maxterjunior/paracaidas-dron/README.md

# Paracaídas de Emergencia para DJI Matrice 400

Sistema autónomo que detecta la caída libre del dron con una IMU y despliega un paracaídas mediante un tubo de muelle. Funciona **independiente del flight controller**: tiene su propia batería, su MCU y su sensor.

<p align="center">
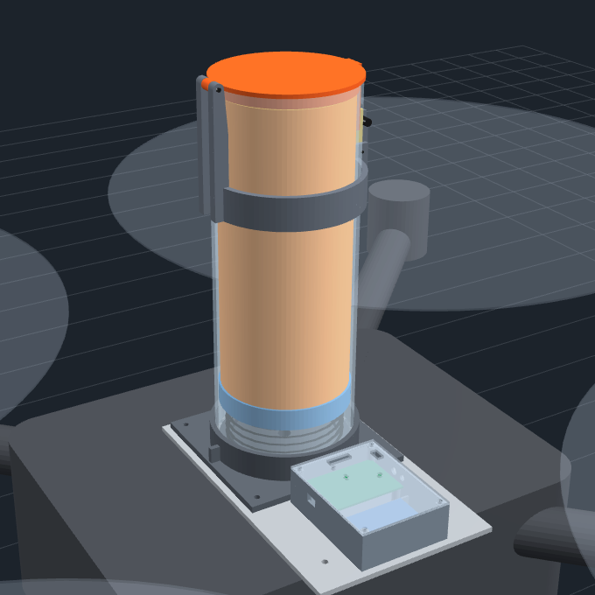
[picture p1: docs/img/mecanismo.png]
Mecanismo de tubo de muelle montado sobre el dron, con la caja de la electrónica al lado
  
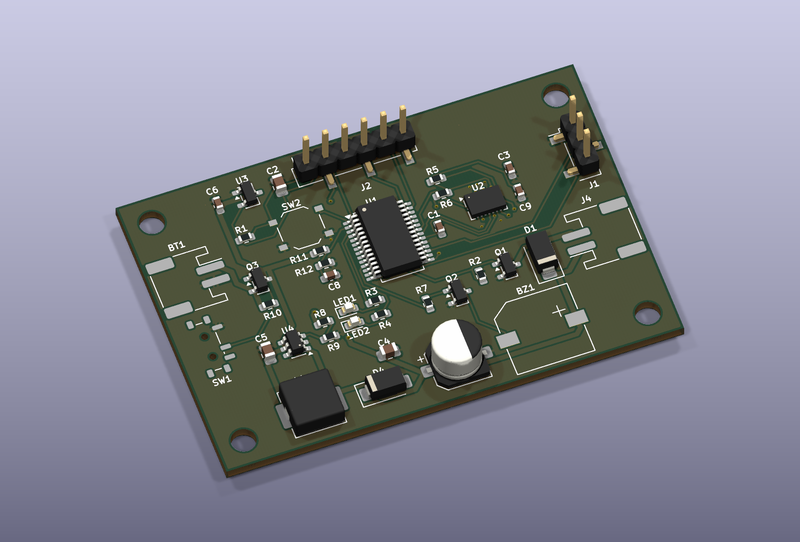
[picture p2: docs/img/pcb.png]
Render 3D de la placa de control de 60 × 40 mm
  
</p>
<p align="center"><sub>Izquierda: mecanismo en el <a href="https://claude.ai/artifact/HH7TuvKMzHhvBDsvPzRwz9">visor 3D</a>. Derecha: placa de control (render de KiCad).</sub></p>

| | |
|---|---|
| **Dron objetivo** | DJI Matrice 400: 9.74 kg con baterías, MTOW 15.8 kg |
| **MCU** | PIC18F25K22 (SSOP-28) con oscilador interno de 16 MHz sin PLL, 3.3 V |
| **IMU** | BMI088 (acelerómetro ±12 g + giróscopo ±1000 °/s) soldado en la placa, I²C: acel. 0x18 / giro 0x68 |
| **Actuador** | Solenoide 5 V que libera el pestillo de un tubo de muelle |
| **Mecanismo** | Tubo Ø100 × 280 mm con tapa articulada, modelo paramétrico OpenSCAD y [visor 3D](https://claude.ai/artifact/HH7TuvKMzHhvBDsvPzRwz9) |
| **Paracaídas** | Circular, ripstop nylon 30D, **Ø3.5 m**, 12 gajos, descenso ≤ 6 m/s a 16 kg |
| **Alimentación** | LiPo 1S 1000 mAh → interruptor MOSFET → LDO 3.3 V (XC6206) + boost 5.1 V (MT3608) |

## Estado

| Área | Estado |
|---|---|
| Investigación de módulos y paracaídas | ✅ Completa |
| Esquemático (KiCad 10, rev. v4, todo SMD) | ✅ Cableado, ERC limpio, campo LCSC en cada componente |
| PCB 2 capas 60 × 40 mm | ✅ Ruteado, planos de GND, DRC limpio, archivos JLCPCB listos |
| Firmware (MPLAB XC8) | 🚧 v0.1.0 escrita, sin compilar ni probar en hardware |
| Mecanismo (tubo de muelle) | 🚧 Modelo 3D y STL listos, sin interferencias; faltan medidas reales del solenoide y del montaje en el M400 |
| Canopia | ⏳ Pendiente (comprar o coser, ver `modulos.md`) |

## Cómo funciona

```
LiPo 1S ─Q3/SW1─┬─► XC6206 3.3V ─► PIC18F25K22 ◄─I²C─► BMI088
                │                       │
                └─► MT3608 5.1V ────────┼─► AO3400A ─► Solenoide ─► pestillo ─► muelle ─► paracaídas
                                        └─► LEDs / buzzer
```

1. El PIC lee el BMI088 a 500 Hz y filtra las señales con IIR de primer orden (solo aritmética entera, el PIC18 no tiene FPU).
2. Se **arma** solo en vuelo: cuando detecta la vibración de los motores durante 5 s. En tierra no dispara.
3. Armado, despliega si se cumple cualquiera de estos criterios: **caída libre** (|a| < 0.3 g durante 100 ms), **giro descontrolado** (|ω| > 250 °/s durante 300 ms) o **inclinación** (> 70° durante 500 ms).
4. Da dos pulsos de 300 ms al solenoide, que retrae el émbolo que bloquea la palanca del pestillo. La tapa se abre y el muelle expulsa el paracaídas en ~50–100 ms (ver [Mecanismo](#mecanismo)).
5. El pestillo retiene **sin energía**. Un reset nunca despliega por sí solo (R2 mantiene Q1 apagado), pero si el PIC se reinicia *durante* un despliegue, lo repite al arrancar.

Detalles en [`firmware/README.md`](firmware/README.md).

### Limitaciones conocidas

- **Altura mínima de despliegue: ~20–40 m.** Entre detección, expulsión e inflado se pierden 1.5–2.5 s.
- **La caída libre sola no basta.** Si falla un motor, el dron gira con los demás empujando y el acelerómetro no ve 0 g. Por eso el firmware también dispara por giro e inclinación. Falta un disparo manual por radio (RB2 libre) y calibrar los umbrales con vuelos reales.
- **No corta los motores.** El tubo debe expulsar hacia arriba, fuera del plano de las hélices.

## Estructura del repositorio

```
paracaidas-dron/
├── docs/
│   ├── esquematicos/esquematico.md   # Fuente de verdad: componentes, netlist pin a pin, notas
│   └── investigacion/modulos.md      # Selección de módulos, cálculo y construcción del paracaídas
├── hardware/
│   ├── paracaidas-matrice400/        # Proyecto KiCad 10 (.kicad_pro / .kicad_sch / .kicad_pcb)
│   │   ├── paracaidas.kicad_sym      # Símbolo propio (BMI088 en modo I2C)
│   │   ├── paracaidas.pretty/        # Footprint propio (buzzer MLT-9650)
│   │   └── jlcpcb/                   # Gerbers, BOM y CPL para pedir la placa armada
│   └── mecanismo/
│       ├── mecanismo.scad            # Modelo paramétrico OpenSCAD (tubo, tapa, pestillo, caja, adaptador)
│       ├── stl/                      # Piezas imprimibles exportadas
│       └── visor/                    # Visor 3D (three.js) generado desde los STL
├── firmware/                         # PIC18F25K22, MPLAB XC8 (ver firmware/README.md)
│   ├── src/                          # main, detector, configuración, placa
│   ├── lib/                          # HAL (tick, I2C, UART, ADC) y driver BMI088
│   └── test/                         # pruebas de la lógica de detección en la PC
├── CLAUDE.md                         # Guía para Claude Code
└── README.md
```

## Primeros pasos

### Abrir el hardware

1. Instala [KiCad 10](https://www.kicad.org/download/).
2. Abre `hardware/paracaidas-matrice400/paracaidas-matrice400.kicad_pro`.

Para verificar el diseño desde la línea de comandos:

```sh
KICAD="C:/Program Files/KiCad/10.0/bin/kicad-cli.exe"
cd hardware/paracaidas-matrice400

"$KICAD" sch erc paracaidas-matrice400.kicad_sch
"$KICAD" pcb drc --schematic-parity paracaidas-matrice400.kicad_pcb
```

### Firmware

```sh
cd firmware
make          # build/paracaidas.hex (MPLAB XC8)
make test     # lógica de detección en la PC (gcc)
```

- Programado con PICkit por el header ICSP **J2** (RB6/RB7).
- Log de estado por el header UART **J1** (RC6 TX / RC7 RX), 115200 8N1.
- Instrucciones, estados, LEDs y calibración en [`firmware/README.md`](firmware/README.md).

## Cambiar el diseño

[`docs/esquematicos/esquematico.md`](docs/esquematicos/esquematico.md) es la **fuente de verdad** de la conectividad. Las referencias coinciden 1:1 con el `.kicad_sch` y el `.kicad_pcb`.

Para cualquier cambio de conexiones:

1. Actualiza el documento **y** el esquemático, y corre el ERC.
2. Actualiza el PCB desde el esquemático (F8) y vuelve a rutear las redes afectadas.
3. Rellena las zonas (B) y corre el DRC con `--schematic-parity`.

Netclasses del PCB: `Default` 0.2 mm con 0.15 mm de separación (paso fino del SSOP-28 y del LGA-16) y `Power` 0.6 mm (+5V, VBAT, SW_NODE, SOL_DRV, BAT+). GND va por plano de cobre en ambas caras.

### Pedir la placa a JLCPCB

1. Sube `hardware/paracaidas-matrice400/jlcpcb/paracaidas-matrice400-gerbers.zip` (se genera junto con los gerbers y no se versiona; si no está, comprime la carpeta `gerbers/`).
2. En PCB Assembly sube `bom_jlcpcb.csv` y `cpl_jlcpcb.csv` (cara superior).
3. Revisa la rotación de los componentes en el visor antes de confirmar. Todos los componentes, incluidos los conectores, los monta JLCPCB.

Si cambias el PCB, vuelve a exportar gerbers, taladros y posiciones con `kicad-cli pcb export gerbers|drill|pos`.

## Mecanismo

Tubo de muelle montado sobre el dron con una placa adaptadora. **[Ver el modelo en 3D](https://claude.ai/artifact/HH7TuvKMzHhvBDsvPzRwz9)**: tiene animación del despliegue, vista en corte y el nombre de cada pieza al pasar el ratón.

| Pieza | Qué hace | Material |
|---|---|---|
| Tubo Ø105/Ø100 × 280 mm | Aloja ~1.6 L de paracaídas plegado | PETG impreso o tubo PVC 110 mm |
| Base | Encaje del tubo, asiento del resorte, paso central del cordón de anclaje | PETG |
| Pistón | Empuja el paracaídas | PETG |
| Resorte Ø90 mm | Comprimido a 45 mm en vuelo | Acero (comprado) |
| Tapa articulada | Se abre sobre su bisagra y queda unida al tubo; su pestaña tiene la ventana del pestillo | PETG |
| Collar | Bisagra, pivote de la palanca, guía del émbolo y repisa del solenoide | PETG |
| Palanca del pestillo | Su gancho entra en la ventana de la tapa | PETG o PA |
| Solenoide 5 V push-pull | El émbolo bloquea la palanca de costado | JF-0530B (comprado) |
| Caja electrónica | PCB 60 × 40 + LiPo 1S; tapa con agujeros sobre LEDs, buzzer, reset, J1 y J2 | PETG |
| Placa adaptadora | Une tubo y caja al dron | Aluminio 4 mm o PETG |

**Cómo traba:** la carga del resorte pasa a 2.7 mm del pivote de la palanca, así que el émbolo solo la bloquea de costado y le basta un solenoide pequeño. Sin energía, el muelle del solenoide deja el émbolo extendido y la tapa trabada. La boca del tubo queda ~273 mm por encima del plano de las hélices.

**Verificado con OpenSCAD:** ninguna pieza montada se cruza con otra. La tapa abre de 0° a 118° sin chocar, la palanca gira 22° libre con el émbolo retraído y queda bloqueada con el émbolo extendido.

**Antes de fabricar hay que medir:**

- El solenoide real (cuerpo, carrera, largo del émbolo): parámetros `sol_*`.
- El punto de montaje superior del M400: el patrón de tornillos de la placa (`montaje_*`) y la envolvente del dron son provisionales.
- La fuerza del resorte: debe sacar ~0.6 kg por encima de las hélices. Probar en banco.

> El cordón de anclaje se ata a la **estructura del dron**, no a piezas impresas: el choque de apertura con 16 kg es de cientos de newtons.

### Exportar las piezas

Instala [OpenSCAD](https://openscad.org/downloads.html) y exporta cada pieza:

```sh
cd hardware/mecanismo
openscad -D 'pieza="tapa"' -o stl/tapa.stl mecanismo.scad
```

Piezas imprimibles: `base`, `tubo`, `piston`, `tapa`, `collar`, `palanca`, `caja`, `tapa_caja`, `adaptador`. Las medidas están como parámetros al inicio del `.scad`. Los STL salen en posición de montaje, así que hay que orientarlos en el slicer. El tubo necesita ~290 mm de altura de impresión; si no alcanza, usa PVC.

### Visor 3D

`hardware/mecanismo/visor/index.html` se abre con doble clic, sin servidor. Carga las piezas de `piezas.js`, que contiene los STL de OpenSCAD en base64. Si cambias el `.scad`, regenera ese archivo:

```sh
python hardware/mecanismo/visor/empaquetar.py "C:/Program Files/OpenSCAD/openscad.com"
```

## Paracaídas

El dimensionamiento completo, el patrón de gajos, la costura y los proveedores (Fruity Chutes, Mars Parachutes, modelos para 15–16 kg) están en [`docs/investigacion/modulos.md`](docs/investigacion/modulos.md#paracaídas--canopia-y-mecanismo-de-despliegue).

```
Área = 2·m·g / (Cd·ρ·v²) = (2 × 16 × 9.81) / (0.75 × 1.225 × 6²) ≈ 9.5 m²  →  Ø3.5 m
```

> Los paracaídas de Ø1.2 m que venden en AliExpress son para drones de 2–4 kg. Con el M400 darían 14–17 m/s de descenso, el equivalente a soltarlo desde 10–15 m.

## Commits

Este repo usa [Conventional Commits](https://www.conventionalcommits.org/es/v1.0.0/) con emoji y la descripción en español:

```
feat(hardware): ✨ esquemático cableado sin r5/r6 y pcb ruteado con plano de gnd
```
