maxterjunior/paracaidas-dron/hardware/mecanismo/visor/index.html

Mecanismo Pestillo Dron Paracaídas

arrastrar: girar · rueda: zoom · clic derecho: desplazar
dron = envolvente aproximada

# Paracaídas M400 · Mecanismo

Tubo de muelle Ø100 × 280 mm con tapa articulada y pestillo por solenoide, montado sobre el dron.

## Despliegue

▶ Disparar

Dron Corte Plano de hélices

## Secuencia

1. En vuelo el solenoide está apagado: su muelle mantiene el émbolo extendido y bloquea la palanca.
2. El PIC detecta la falla y da un pulso de ~300 ms: el émbolo se retrae 10 mm.
3. La carga del resorte cae 2.7 mm por dentro del pivote, así que la palanca gira hacia afuera y suelta la pestaña.
4. La tapa abre sobre su bisagra (queda unida al tubo) y el pistón expulsa el paracaídas hacia arriba.
5. El cordón de anclaje pasa por el centro de la base y va a la estructura del dron.

## Piezas

## Cotas principales

Tubo (interior × largo) | Ø100 × 280 mm
Volumen útil para el paracaídas | ≈ 1.6 L
Boca del tubo sobre el plano de hélices | ≈ 273 mm
Resorte (ext. × comprimido) | Ø90 × 45 mm
Brazo de la carga respecto al pivote | 2.7 mm
Carrera del émbolo | 10 mm
Placa adaptadora | 140 × 232 × 4 mm
Caja electrónica (PCB 60×40 + LiPo) | 70 × 90 × 30 mm

## Por verificar

- Medidas del solenoide real (cuerpo, carrera, largo del émbolo). El modelo usa un JF-0530B de 5 V.
- Patrón de tornillos de la placa adaptadora: es provisional, hay que medir el punto de montaje superior del M400.
- El cordón de anclaje debe ir a la estructura del dron, no a piezas impresas: el choque de apertura con 16 kg es de cientos de newtons.
- Fuerza del resorte para sacar ~0.6 kg por encima de las hélices; probar en banco antes de volar.

## Fuente CAD

Todas las piezas del visor son los STL exportados de hardware/mecanismo/mecanismo.scad con OpenSCAD, los mismos de hardware/mecanismo/stl/, empaquetados en visor/piezas.js con visor/empaquetar.py. Sólo el PCB, la batería, los pasadores y la canopia inflada son esquemáticos. Para exportar una pieza: openscad -D 'pieza="tapa"' -o tapa.stl mecanismo.scad.
