maxterjunior/paracaidas-dron/hardware/paracaidas-matrice400/jlcpcb/bom_jlcpcb.csv

Comment | Designator | Footprint | LCSC Part #
LiPo 1S | BT1 | JST_PH_S2B-PH-SM4-TB_1x02-1MP_P2.00mm_Horizontal | C295747
MLT-9650 5V | BZ1 | Buzzer_MLT-9650 | C96127
100nF | C1,C3,C8,C9 | C_0603_1608Metric | C14663
10µF | C2 | C_0805_2012Metric | C15850
22µF | C4,C5 | C_0805_2012Metric | C45783
1µF | C6 | C_0603_1608Metric | C15849
220µF 10V | C7 | CP_Elec_6.3x5.4 | C72494
SS34 | D1,D4 | D_SMA | C8678
UART debug | J1 | PinHeader_1x03_P2.54mm_Vertical_SMD_Pin1Left | C41417360
ICSP PICkit | J2 | PinHeader_1x06_P2.54mm_Vertical_SMD_Pin1Right | C41417363
SOL1 Solenoide 5V | J4 | JST_PH_S2B-PH-SM4-TB_1x02-1MP_P2.00mm_Horizontal | C295747
22µH 3A | L1 | L_Changjiang_FXL0630 | C177244
Verde | LED1 | LED_0603_1608Metric | C12624
Rojo | LED2 | LED_0603_1608Metric | C2286
AO3400A | Q1 | SOT-23 | C20917
MMBT3904 | Q2 | SOT-23 | C20526
AO3401A | Q3 | SOT-23 | C15127
10k | R1,R2 | R_0603_1608Metric | C25804
100 | R3 | R_0603_1608Metric | C22775
330 | R4 | R_0603_1608Metric | C23138
4.7k | R5,R6 | R_0603_1608Metric | C23162
1k | R7 | R_0603_1608Metric | C21190
750k 1% | R8 | R_0603_1608Metric | C23240
100k 1% | R9 | R_0603_1608Metric | C25803
100k | R10,R11,R12 | R_0603_1608Metric | C25803
ON/OFF | SW1 | SW_SPDT_Shouhan_MSK12C02 | C431540
RESET | SW2 | SW_Push_1P1T_XKB_TS-1187A | C318884
PIC18F25K22-I/SS | U1 | SSOP-28_5.3x10.2mm_P0.65mm | C51680
BMI088 | U2 | Bosch_LGA-16_4.5x3mm_P0.5mm_LayoutBorder7x1y_ClockwisePinNumbering | C194919
XC6206P332MR | U3 | SOT-23-3 | C5446
MT3608 | U4 | SOT-23-6 | C84817
