maxterjunior/paracaidas-dron/hardware/mecanismo/stl/adaptador.stl

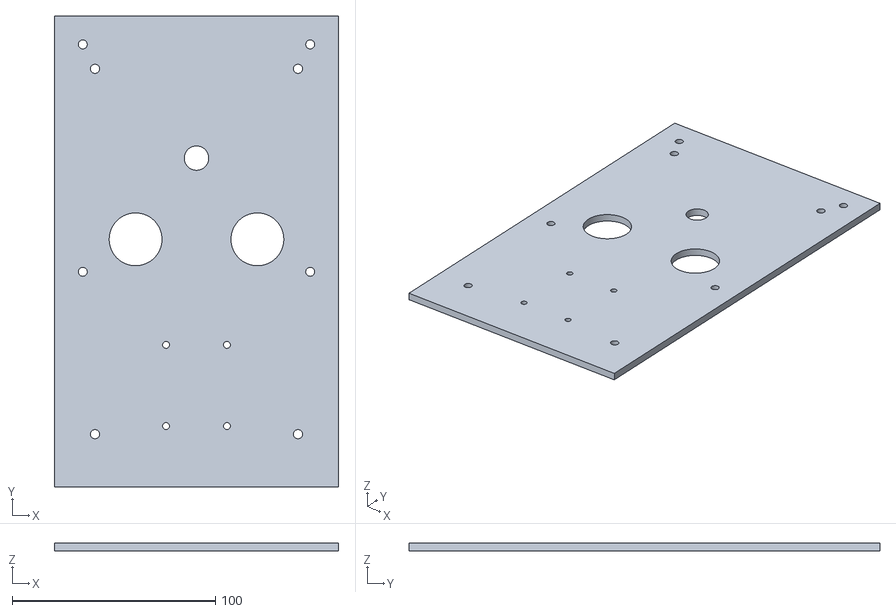
[picture p3: CAD file, 2026-11-09]
hardware/mecanismo/stl/adaptador.stl
140.0 x 232.0 x 4.00
