maxterjunior/paracaidas-dron/hardware/mecanismo/stl/tapa_caja.stl

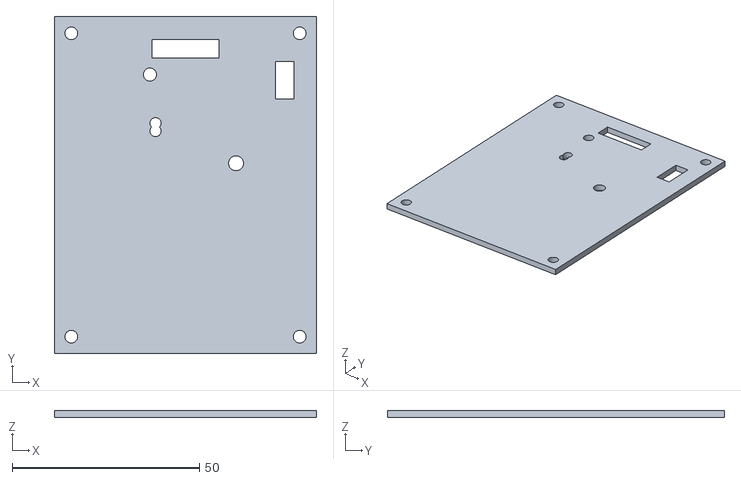
[picture p4: CAD file, 2026-11-09]
hardware/mecanismo/stl/tapa_caja.stl
70.0 x 90.0 x 2.00
