maxterjunior/paracaidas-dron/hardware/mecanismo/stl/collar.stl

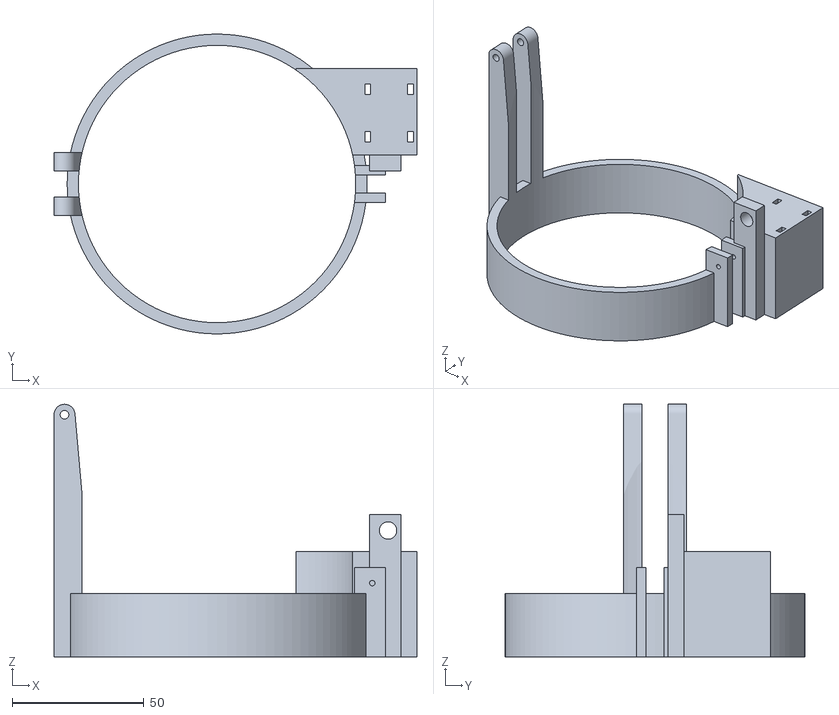
[picture p5: CAD file, 2026-11-09]
hardware/mecanismo/stl/collar.stl
138.0 x 114.0 x 96.0
