maxterjunior/paracaidas-dron/hardware/mecanismo/stl/palanca.stl

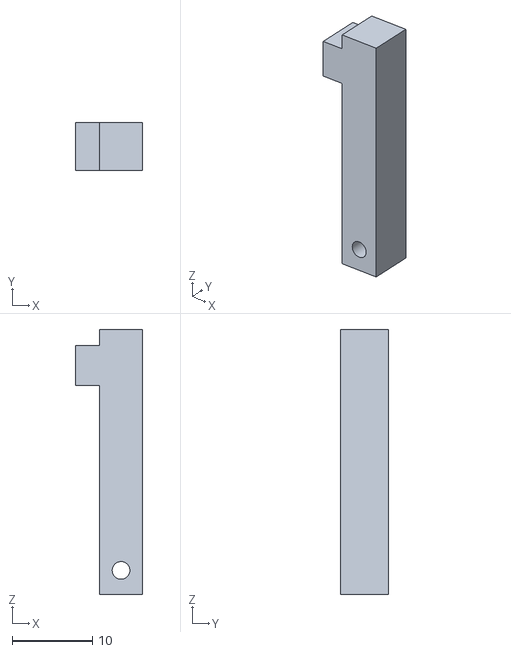
[picture p6: CAD file, 2026-11-09]
hardware/mecanismo/stl/palanca.stl
8.40 x 6.00 x 33.0
