maxterjunior/paracaidas-dron/hardware/mecanismo/stl/piston.stl

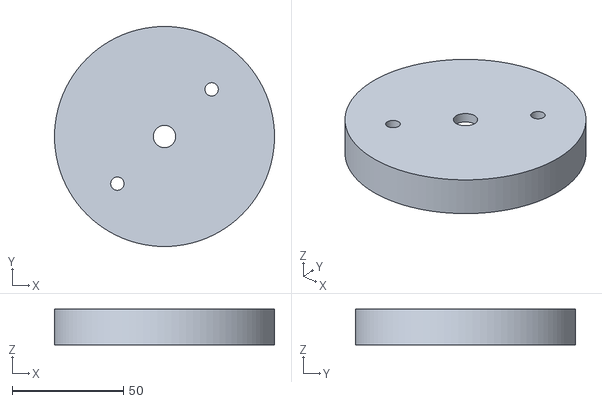
[picture p7: CAD file, 2026-11-09]
hardware/mecanismo/stl/piston.stl
99.0 x 99.0 x 16.0
