maxterjunior/paracaidas-dron/hardware/mecanismo/stl/tubo.stl

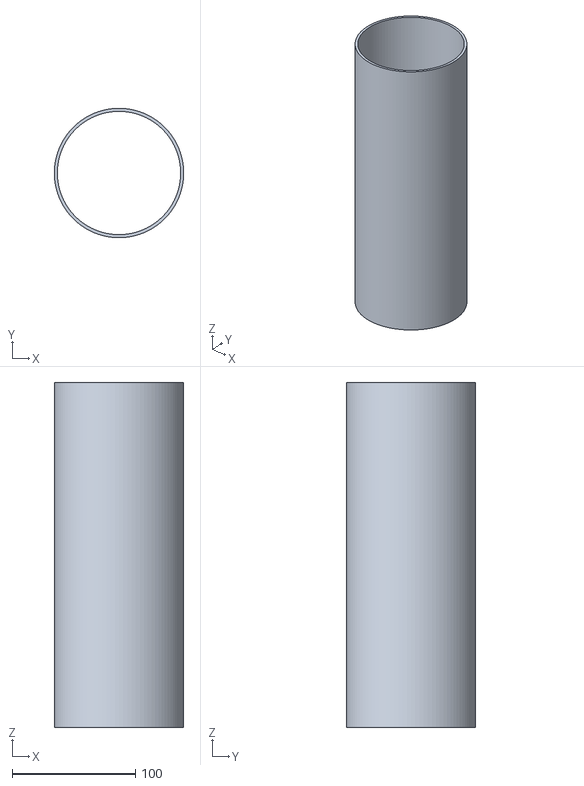
[picture p8: CAD file, 2026-11-09]
hardware/mecanismo/stl/tubo.stl
105.0 x 105.0 x 280.0
