maxterjunior/paracaidas-dron/hardware/mecanismo/stl/base.stl

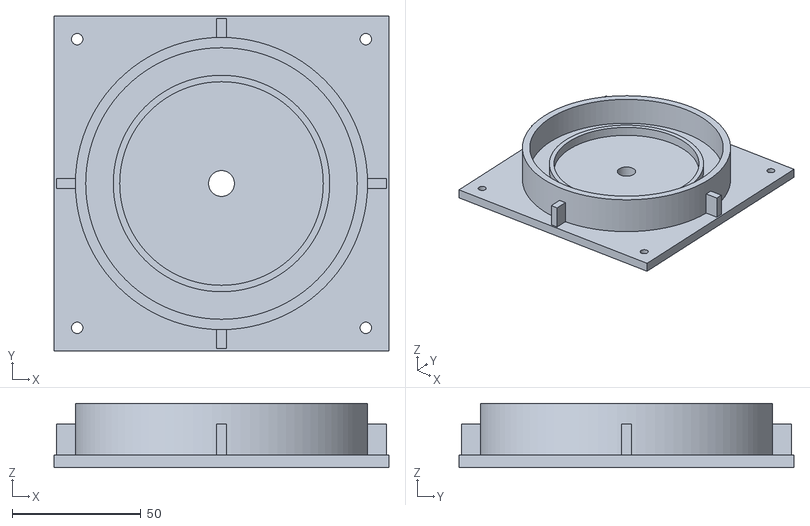
[picture p9: CAD file, 2026-11-09]
hardware/mecanismo/stl/base.stl
130.0 x 130.0 x 25.0
