maxterjunior/paracaidas-dron/hardware/mecanismo/stl/tapa.stl

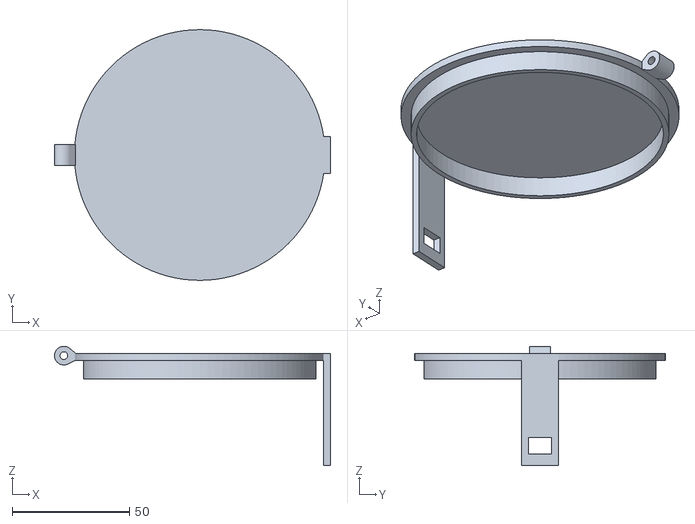
[picture p10: CAD file, 2026-11-09]
hardware/mecanismo/stl/tapa.stl
117.8 x 107.0 x 51.0
