maxterjunior/paracaidas-dron/hardware/mecanismo/stl/caja.stl

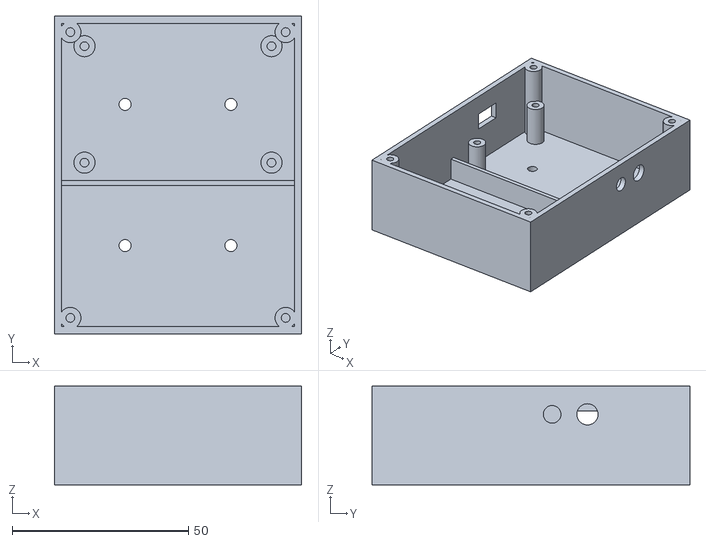
[picture p11: CAD file, 2026-11-09]
hardware/mecanismo/stl/caja.stl
70.0 x 90.0 x 28.0
