maxterjunior/paracaidas-dron/hardware/paracaidas-matrice400/paracaidas-matrice400.kicad_pcb

## KiCad design hardware/paracaidas-matrice400/paracaidas-matrice400.kicad_pcb (2026-11-09)

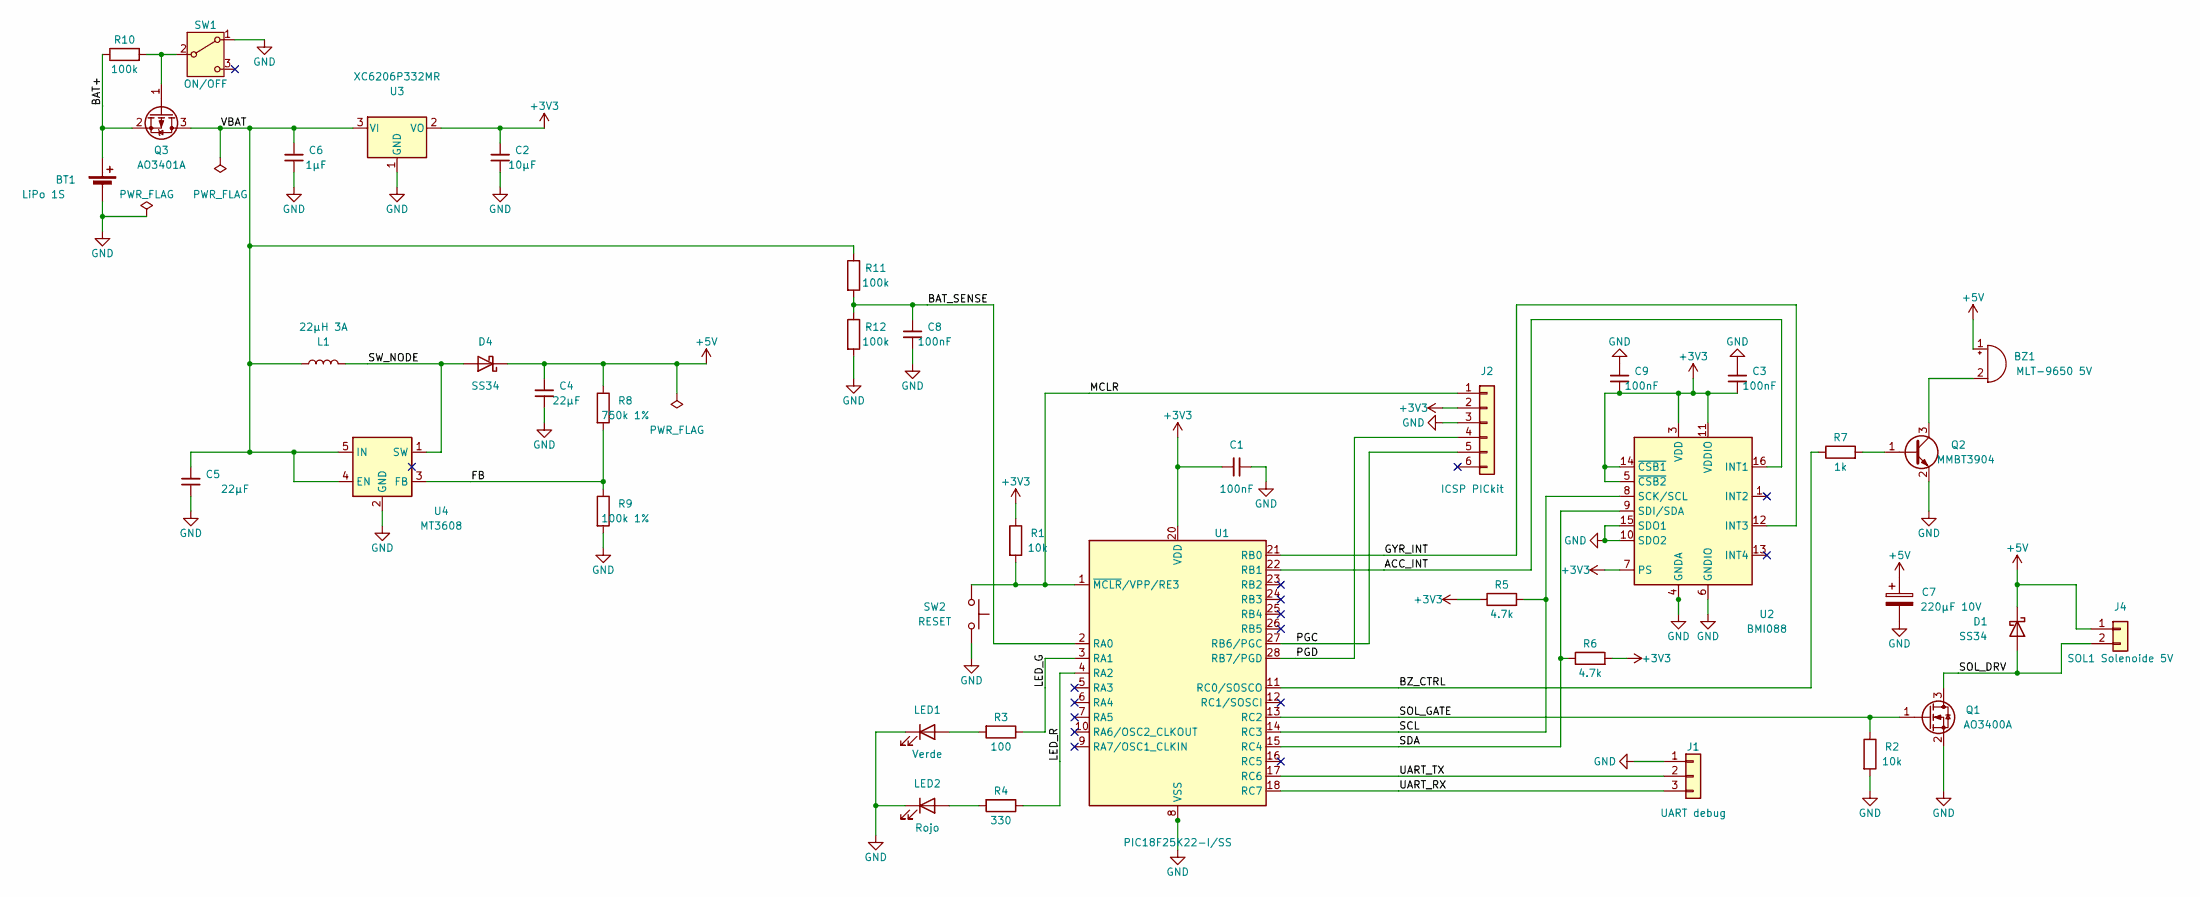
[picture p12: schematic paracaidas-matrice400.kicad_sch, Paracaídas de emergencia — DJI Matrice 400]

Parts:
BT1: LiPo 1S; JST_PH_S2B-PH-SM4-TB_1x02-1MP_P2.00mm_Horizontal; LCSC C295747
BZ1: MLT-9650 5V; Buzzer_MLT-9650; LCSC C96127
C1, C3, C8, C9: 100nF; C_0603_1608Metric; LCSC C14663
C2: 10µF; C_0805_2012Metric; LCSC C15850
C4, C5: 22µF; C_0805_2012Metric; LCSC C45783
C6: 1µF; C_0603_1608Metric; LCSC C15849
C7: 220µF 10V; CP_Elec_6.3x5.4; LCSC C72494
D1, D4: SS34; D_SMA; LCSC C8678
J1: UART debug; PinHeader_1x03_P2.54mm_Vertical_SMD_Pin1Left; LCSC C41417360
J2: ICSP PICkit; PinHeader_1x06_P2.54mm_Vertical_SMD_Pin1Right; LCSC C41417363
J4: SOL1 Solenoide 5V; JST_PH_S2B-PH-SM4-TB_1x02-1MP_P2.00mm_Horizontal; LCSC C295747
L1: 22µH 3A; L_Changjiang_FXL0630; LCSC C177244
LED1: Verde; LED_0603_1608Metric; LCSC C12624
LED2: Rojo; LED_0603_1608Metric; LCSC C2286
Q1: AO3400A; SOT-23; LCSC C20917
Q2: MMBT3904; SOT-23; LCSC C20526
Q3: AO3401A; SOT-23; LCSC C15127
R1, R2: 10k; R_0603_1608Metric; LCSC C25804
R3: 100; R_0603_1608Metric; LCSC C22775
R4: 330; R_0603_1608Metric; LCSC C23138
R5, R6: 4.7k; R_0603_1608Metric; LCSC C23162
R7: 1k; R_0603_1608Metric; LCSC C21190
R8: 750k 1%; R_0603_1608Metric; LCSC C23240
R9: 100k 1%; R_0603_1608Metric; LCSC C25803
R10, R11, R12: 100k; R_0603_1608Metric; LCSC C25803
SW1: ON/OFF; SW_SPDT_Shouhan_MSK12C02; LCSC C431540
SW2: RESET; SW_Push_1P1T_XKB_TS-1187A; LCSC C318884
U1: PIC18F25K22-I/SS; SSOP-28_5.3x10.2mm_P0.65mm; LCSC C51680
U2: BMI088; Bosch_LGA-16_4.5x3mm_P0.5mm_LayoutBorder7x1y_ClockwisePinNu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; LCSC C194919
U3: XC6206P332MR; SOT-23-3; LCSC C5446
U4: MT3608; SOT-23-6; LCSC C84817

Connections:
+3V3: C1.1, C2.1, C3.2, C9.2, J2.2, R1.1, R5.1, R6.2, U1.20 (VDD), U2.3 (VDD), U2.5 (~CSB2), U2.7 (PS), U2.11 (VDDIO), U2.14 (~CSB1), U3.2 (VO)
+5V: BZ1.1 (+), C4.1, C7.1, D1.1 (K), D4.1 (K), J4.1, R8.1
/ACC_INT: U1.22 (RB1), U2.16 (INT1)
/BAT+: BT1.1 (+), Q3.2 (S), R10.1
/BAT_SENSE: C8.1, R11.2, R12.1, U1.2 (RA0)
/BZ_CTRL: R7.1, U1.11 (RC0/SOSCO)
/FB: R8.2, R9.1, U4.3 (FB)
/GYR_INT: U1.21 (RB0), U2.12 (INT3)
/LED_G: R3.1, U1.3 (RA1)
/LED_R: R4.1, U1.4 (RA2)
/MCLR: J2.1, R1.2, SW2.1, U1.1 (~MCLR/VPP/RE3)
/PGC: J2.5, U1.27 (RB6/PGC)
/PGD: J2.4, U1.28 (RB7/PGD)
/SCL: R5.2, U1.14 (RC3), U2.8 (SCK/SCL)
/SDA: R6.1, U1.15 (RC4), U2.9 (SDI/SDA)
/SOL_DRV: D1.2 (A), J4.2, Q1.3 (D)
/SOL_GATE: Q1.1 (G), R2.1, U1.13 (RC2)
/SW_NODE: D4.2 (A), L1.2, U4.1 (SW)
/UART_RX: J1.3, U1.18 (RC7)
/UART_TX: J1.2, U1.17 (RC6)
/VBAT: C5.1, C6.1, L1.1, Q3.3 (D), R11.1, U3.3 (VI), U4.4 (EN), U4.5 (IN)
GND: BT1.2 (-), C1.2, C2.2, C3.1, C4.2, C5.2, C6.2, C7.2, C8.2, C9.1, J1.1, J2.3, LED1.1 (K), LED2.1 (K), Q1.2 (S), Q2.2 (E), R2.2, R9.2, R12.2, SW1.1 (A), SW2.2, U1.8 (VSS), U1.19 (VSS), U2.2 (GNDA), U2.4 (GNDA), U2.6 (GNDIO), U2.10 (SDO2), U2.15 (SDO1), U3.1 (GND), U4.2 (GND)
unnamed: BZ1.2 (-), Q2.3 (C)
unnamed: LED1.2 (A), R3.2
unnamed: LED2.2 (A), R4.2
unnamed: Q2.1 (B), R7.2
unnamed: Q3.1 (G), R10.2, SW1.2 (B)

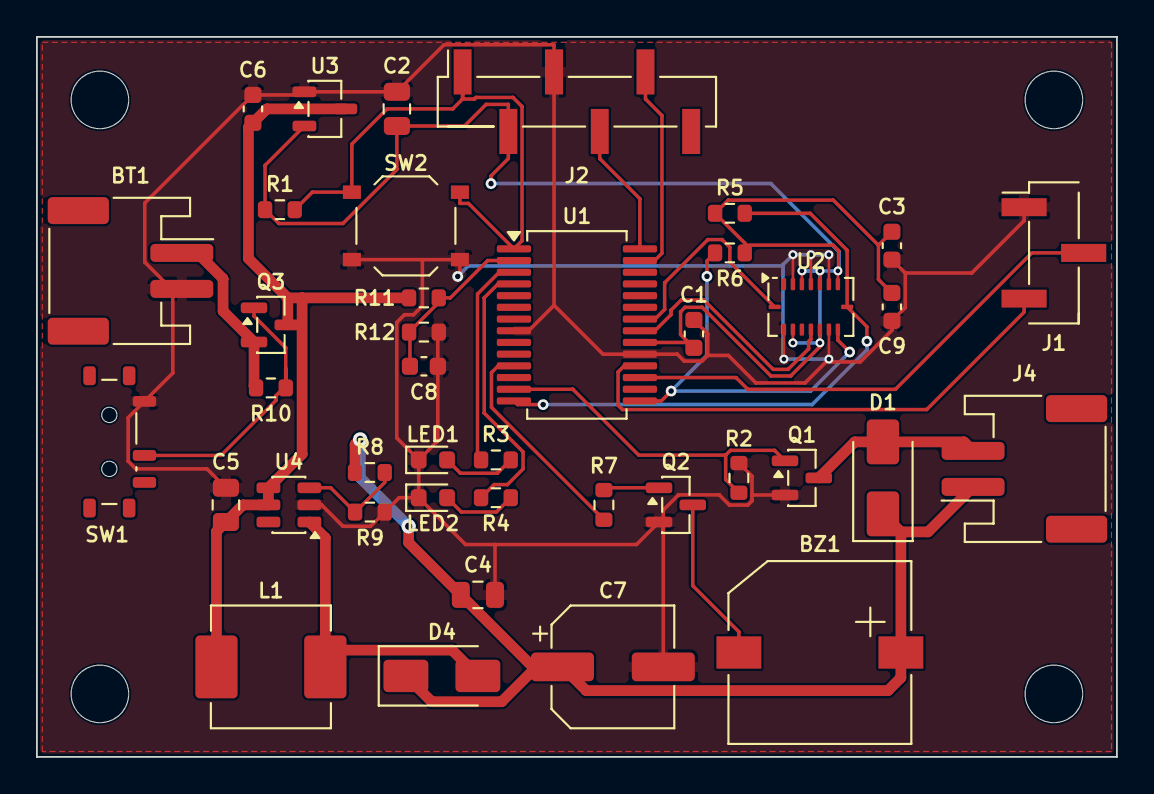
[picture p13: board paracaidas-matrice400.kicad_pcb from above]

Board: 2 copper layers, 60.0 x 40.0 mm, 44 parts (0 on the bottom side), 27 nets.

Other parts of the board:
H1, H2, H3, H4: M3; MountingHole_3.2mm_M3
