maxterjunior/paracaidas-dron/(commit log)

2026-03-28 Initial commit: esquemáticos KiCad y documentación del paracaídas para drones
    [paracaidas-matrice400.kicad_pcb, paracaidas-matrice400.kicad_sch]
2026-03-29 Implementa esquemático KiCad completo: sistema paracaídas DJI Matrice 400
    - 31 componentes: PIC18LF25K22, MPU-6050, MT3608, MCP1700-3302E,
    IRLZ44N, 2N3904, 1N4007, resistencias, capacitores, inductor,
    LEDs, buzzer, solenoid, batería, switches, conectores UART/ICSP
    - 24 nets verificados con kicad-happy: SCL/SDA/I2C, MPU_INT,
    SOL_CTRL, BUZ_CTRL, LED1/LED2, MCLR, UART_TX/RX, PGC/PGD,
    VBAT, VBAT_SW, BOOST_SW, BOOST_FB, +3V3, +5V, GND, DRAIN_Q1
    - gen_sch.py: generador Python que aplica la misma fórmula de
    coordenadas que el analizador (abs_y = cy - rpy, Y invertido)
    [paracaidas-matrice400.kicad_sch]
2026-03-29 Fix: referencias duplicadas #PWR en símbolos de alimentación
    Cada símbolo de power (GND, +3V3, +5V, VBAT, etc.) ahora recibe
    una referencia única (#PWR001..#PWR058) — resuelve el error
    "Duplicar elementos #PWR01" al hacer Update PCB from Schematic (F8).
    [paracaidas-matrice400.kicad_sch]
2026-03-30 Refactor code structure for improved readability and maintainability
    [paracaidas-matrice400.kicad_pcb, paracaidas-matrice400.kicad_sch, schematic_analysis.json]
2026-05-16 Add lock file for paracaidas-matrice400 schematic with user and hostname information
    [paracaidas-matrice400.kicad_pcb, paracaidas-matrice400.kicad_sch, schematic_analysis.json]
2026-05-17 Remove lock file for paracaidas-matrice400 schematic
2026-11-09 fix(hardware): 🐛 esquemático v3 con schottky del boost, ao3400a y lógica de liberación por pulso
    El esquemático anterior no tenía conexiones, usaba LEDs infrarrojos y el
    MT3608 no tenía diodo de salida (sin él no hay 5V). El IRLZ44N no garantiza
    conducción plena con 3.3V en el gate, y la lógica "solenoide energizado =
    retenido" agotaba la batería y desplegaba el paracaídas en cada reset.
    - esquemático rehecho y cableado completo (ERC: 0 errores, 0 advertencias)
    - D4 SS34 + topología boost correcta, Q1 AO3400A, C6 1µF, C5 22µF
    - J1 UART, J2 ICSP, J3 GY-521, J4 solenoide, BT1 JST-PH
    - docs y CLAUDE.md actualizados a v3; *.lck en .gitignore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
2026-11-09 feat(hardware): ✨ esquemático cableado sin r5/r6 y pcb ruteado con plano de gnd
    El esquemático pasa de etiquetas a cables reales para poder seguir las
    conexiones. Se eliminan R5/R6 (DNP) porque el GY-521 ya trae pull-ups.
    El PCB se ubica por bloques y se rutea con Freerouting (2 vías), con
    plano de GND en ambas capas. La clase Power baja a 0.6 mm porque el
    SOT-23-6 del MT3608 no admite pistas de 0.8 mm. ERC y DRC limpios.
2026-11-09 docs: 📝 corrige dimensionamiento del paracaídas a ø3.5 m y agrega mejoras pendientes
    El cálculo anterior (0.82 m², Ø1.2 m) tenía un error aritmético y usaba
    un peso desactualizado del M400. Con 16 kg (MTOW 15.8 kg + sistema) se
    necesitan 9.5 m² (Ø3.5 m) para descender a 6 m/s; Ø1.2 m da 14-17 m/s.
    Se actualizan el patrón de costura, las cuerdas y se documentan las
    mejoras críticas: disparo por giroscopio y por radio, armado, caída de
    tensión en el pulso, hélices, altura mínima y ajustes del PCB.
2026-11-09 docs: 📝 readme actualizado para el sistema del matrice 400
    El readme anterior describía una estructura que no existe (firmware/, EasyEDA)
    y no mencionaba el dron objetivo ni el estado del diseño.
2026-11-09 feat(hardware): ✨ v4 todo smd con stock jlcpcb, bmi088 y pcb de 60x40 mm
    Todos los componentes pasan a SMD con número LCSC en stock en JLCPCB y
    la placa se reduce de 90x62 a 60x40 mm. El GY-521 se reemplaza por un
    BMI088 soldado en la placa, el PIC18LF por el PIC18F25K22 SSOP-28 (el LF
    SMD no tiene stock) y el MCP1700 por el XC6206. Se agrega un interruptor
    de carga con MOSFET P, medición de batería en RA0 y un bulk de 220 µF
    para el pulso del solenoide. Incluye gerbers, BOM y CPL para JLCPCB.
    ERC y DRC limpios.
2026-11-09 fix(hardware): 🐛 referencias de componentes en la serigrafía del pcb
    Las referencias estaban en F.Fab, que no se fabrica, y el gerber de
    serigrafía solo traía los contornos. Se pasan a F.Silkscreen (0.8 mm,
    trazo 0.15 mm) en posiciones libres de pads y otros textos, y se
    regeneran gerbers y taladros. DRC limpio.
2026-11-09 feat(hardware): ✨ conectores j1 y j2 con stock jlcpcb para montaje completo
    J1 (UART) y J2 (ICSP) pasan a headers SMD de LCSC (C41417360 y
    C41417363) para que JLCPCB monte la placa completa. J2 usa el footprint
    Pin1Right para coincidir con el pin 1 de la pieza, lo que obligó a
    re-rutear el PCB. Se regeneran gerbers, BOM y CPL. ERC y DRC limpios.
2026-11-09 feat(mecanismo): ✨ modelo 3d paramétrico del tubo de muelle y montaje sobre el m400
    Tubo Ø100×280 con tapa articulada, pestillo de palanca bloqueado por el
    émbolo de un solenoide 5 V, base, pistón, collar, caja para el PCB y la
    LiPo y placa adaptadora. Las medidas del dron, el patrón de montaje y el
    solenoide son provisionales y hay que verificarlas.
2026-11-09 fix(mecanismo): 🐛 interferencia de la bisagra con el tubo y stl de las piezas
    El refuerzo de la bisagra de la tapa bajaba ~0.5 mm dentro del borde del
    tubo. Los separadores y tetones de la caja quedaban tangentes al piso y a
    las paredes y daban una malla no manifold. Se agregan los STL de las 9
    piezas imprimibles exportados con OpenSCAD 2021.01, sin interferencias
    entre piezas montadas ni en el recorrido de la tapa (0–118°) y la palanca.
2026-11-09 feat(firmware): ✨ firmware inicial con detección, armado por vibración y despliegue
    Primera versión para el PIC18F25K22 (XC8, 16 MHz sin PLL). Detecta caída
    libre, giro descontrolado e inclinación con el BMI088; solo dispara en
    vuelo, inferido de la vibración de los motores. Repite el pulso si el PIC
    se reinicia durante el despliegue y vuelve a ARMADO tras un reset en
    vuelo. Incluye HAL (tick, I2C con timeouts, UART, ADC), driver BMI088,
    pruebas de la lógica en PC y Makefile. Aún sin compilar ni probar en
    hardware.
2026-11-09 chore(hardware): 🔧 lista de compra lcsc para montar 5 placas a mano
    Cantidades para 5 placas con repuestos (tiras mínimas en pasivos,
    BMI088 extra) para pedir PCB + stencil a JLCPCB y componentes sueltos
    en LCSC con envío combinado.
2026-11-09 feat(mecanismo): ✨ visor 3d generado desde los stl de openscad
    El visor carga las piezas exportadas de mecanismo.scad en lugar de
    redibujarlas a mano, así que siempre coincide con el modelo CAD.
    empaquetar.py exporta cada pieza con OpenSCAD y la guarda como STL binario
    en base64 dentro de piezas.js, porque los artifacts no sirven .stl; de paso
    el visor funciona abriendo index.html sin servidor. Las hélices pasan a un
    módulo propio para poder ocultarlas.
2026-11-09 fix(mecanismo): 🐛 visor congelado al mover la línea de tiempo
    El primer cuadro tras pulsar Disparar podía traer una marca de tiempo
    anterior a performance.now(); el avance salía negativo, t < 0 no encontraba
    fase y la excepción cortaba el bucle de render antes de pedir el siguiente
    cuadro. Se limita t a [0, 1], se ignoran avances negativos y el siguiente
    cuadro se pide al inicio del bucle.
2026-11-09 fix(hardware): 🐛 encabezados en inglés para el bom tool de lcsc
    El BOM Tool de LCSC solo asigna las columnas automáticamente con
    encabezados en inglés (LCSC Part Number, Quantity).
2026-11-09 docs: 📝 readme con el mecanismo de tubo de muelle y el visor 3d
2026-11-09 docs: 📝 claude.md con el mecanismo, su verificación y el visor 3d
2026-11-11 docs: 📝 readme con renders del mecanismo y la placa
    Agrega una captura del visor 3D y un render de KiCad de la PCB, y corrige
    la tabla: oscilador de 16 MHz sin PLL y acelerómetro configurado a ±12 g,
    como en el firmware.
2026-11-11 fix(docs): 🐛 imágenes del readme lado a lado en github
    Con altura fija de 360 px sumaban más que el ancho del readme de github
    (~830 px) y la segunda bajaba de línea. Con anchos en porcentaje siempre
    caben en la misma fila.
